Lab217Oficial/Badge_AHAU-CTF_26/Hardware/BOM_AHAU_CTF_Badge_2026.csv

No. | Quantity | Comment | Designator | Footprint | Value | Manufacturer Part | Manufacturer | Supplier Part | Supplier | Pin Count | Category | Description | Datasheet | Width | Mounting Style
1 | 14 | 1uF | C1,C2,C3,C4,C5,C6,C7,C8,C9,C10,C11,C12,C13,C21 | C0603 | 1uF | CL10A105KB8NNNC | SAMSUNG(三星) | C15849 | LCSC | 2 | 電容:0603 | Capacitance:1uF Tolerance:±10% Tolerance:±10% Voltage Rated:50V Temperature Coefficient:X5R | https://atta.szlcsc.com/upload/public/pdf/source/20160103/1457707679084.pdf |  | SMT
2 | 1 | 1000uF | C14 | CAP-SMD_BD12.5-L12.8-W12.8-LS13.5-FD | 1000uF | EDH108M025A9RAA | KEMET(基美) | C2166241 | LCSC | 2 | Capacitors:Aluminum Electrolytic Capacitors - SMD | Capacitance:1000uF Tolerance:±20% Tolerance:±20% Voltage Rating:25V Ripple Current:510mA@120Hz Diameter:12.5mm Lifetime:2000hrs@105℃ Operating Temperature:-40℃~+105℃ Operating Temperature:-40℃~+105℃ Polarity type:有极性 | https://item.szlcsc.com/datasheet/EDH108M025A9RAA/2258293.html |  | SMT
3 | 1 | PH2.0-2PWT | CN1 | CONN-SMD_PH2.0-2PWT |  | PH2.0-2PWT | XUNPU(讯普) | C52037422 | LCSC | 4 | Connectors:Wire To Board Connector | Pins Structure:1x2P Pitch:2mm Mounting Type:Surface Mount, Right Angle Reference Series:PH Number of Pins:2P Number of Rows:1 Number of PINs Per Row:2 Current Rating:2A Contact Material:Brass Contact Plating:Tin Operating Temperature:-40℃~+85℃ Operating T | https://item.szlcsc.com/datasheet/PH2.0-2PWT/54795753.html |  | SMT
4 | 2 | Screw-Hole-M3 | SCREW1,SCREW2 | M3 Hole |  |  |  |  |  | 1 |  |  |  |  | DIP
5 | 1 | MST-12D18G4 SPDT Slide Switch | SW1 | SW-SMD_MST-12D18G4-SPDT-SLIDE-SWITCH |  | MST-12D18G4 SPDT Slide Switch | SHOU HAN(首韩) | C49023767 | LCSC | 3 | Switches:Slide Switches | Circuit:SPDT Actuator Style:Rectangular Columnar Termination Style:SMD(SMT) Tab Length:9.1mm Width:3.5mm Switch Height:7.5mm Mounting Type:Surface Mount, Right Angle Actuator Color:Black Current Rating:100mA Voltage Rating:12V Life:10,000 Cycles Operating | https://item.szlcsc.com/datasheet/MST-12D18G4%2520SPDT%2520Slide%2520Switch/51384142.html | 3.5mm | SMT
6 | 2 | SWITCH TACTILE | SW2,SW3 | SW-SMD_4P-L5.2-W5.2-P3.7-LS6.4-1 |  | SWITCH TACTILE | hanxia(韩下) | C49234130 | LCSC | 4 | Switches:Tactile Switches | Circuit:SPST Actuator Style:Round Button Operating Force:2.5N Mounting Type:Surface Mount,Vertical Length:5.2mm Width:5.2mm Switch Height:1.5mm with Bracket:Without Bracket Contact Current:50mA Voltage Rating:12V Actuator/Cap Color:Yellow With Lamp:No IP | https://item.szlcsc.com/datasheet/HX%25205.2x5.2x1.5H%2520SWITCH%2520TACTILE/51650191.html | 5.2mm | SMT
7 | 14 | WS2812B-B-V6 | U1,U2,U3,U4,U5,U6,U7,U8,U9,U10,U11,U12,U13,U14 | LED-SMD_4P-L5.0-W5.0-TL_WS2812B-B |  | WS2812B-B-V6 | worldsemi | C52941391 | LCSC | 4 | Optoelectronics:RGB LEDs(Built-in IC) |  | https://item.szlcsc.com/datasheet/WS2812B-B-V6/55856754.html |  | SMT
8 | 1 | Header9P_2.54 | U15 | HDR-TH_9P-P2.54-V-M |  |  |  |  |  | 9 |  |  |  |  | DIP
9 | 1 | ESP32S3_SUPERMINI | U16 | ESP32-S3-SUPERMINI |  |  |  |  |  | 20 |  | esp32 s3 supermini with all of the pins |  |  | SMT
