Lab217Oficial/Badge_AHAU-CTF_26/Hardware/3D_Badge_AHAU_CTF_2026.step

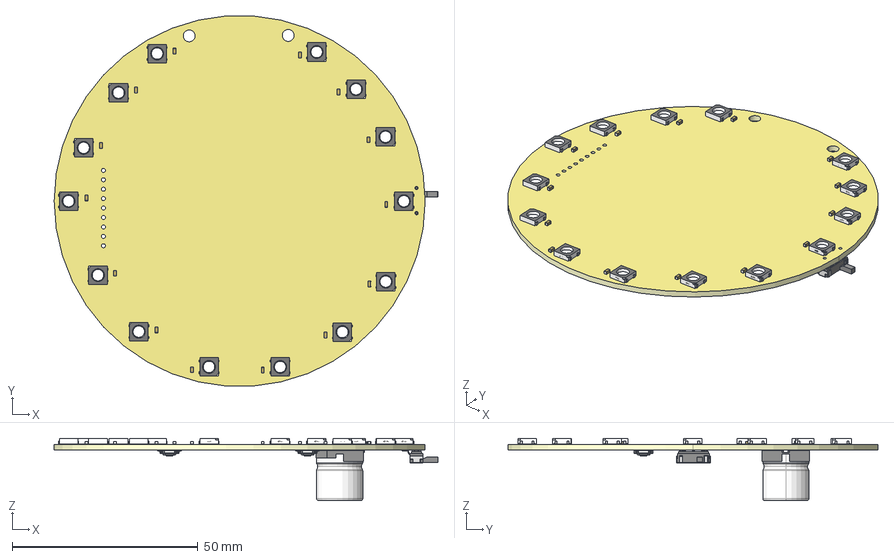
[picture p2: CAD file, 2026-10-14]
Hardware/3D_Badge_AHAU_CTF_2026.step
103.4 x 99.7 x 16.7 mm
Board~4IsV
TopCopper~4IsV
BottomCopper~4IsV
TopSilkscreen~4IsV
BottomSilkscreen~4IsV
TopFpcStiffener~4IsV
BottomFpcStiffener~4IsV
C0603~C0603_L1.6-W0.8-H0.8~4IsV x 14
CAP-SMD_BD12.5-L12.8-W12.8-LS13.5-FD~CAP-SMD_ BD12.5-L12.8-W12.8-LS13.5-FD~4IsV
LED-SMD_4P-L5.0-W5.0-TL_WS2812B-B~LED-SMD_4P-L5.0-W5.0-H1.57-TL_ WS2812B-B~4IsV x 14
SW-SMD_4P-L5.2-W5.2-P3.7-LS6.4-1~SW-SMD_4P-L5.2-W5.2-P3.7-LS6.4-1~4IsV x 2
SW-SMD_MST-12D18G4-SPDT-SLIDE-SWITCH~SW-SMD_ MST-12D18G4-SPDT-SLIDE-SWITCH~4IsV
