Lab217Oficial/Badge_AHAU-CTF_26/Hardware/SCH_Badge_AHAU_CTF_2026.pdf

VOUT_5V | VOUT_5V
VOUT_5V | VOUT_5V

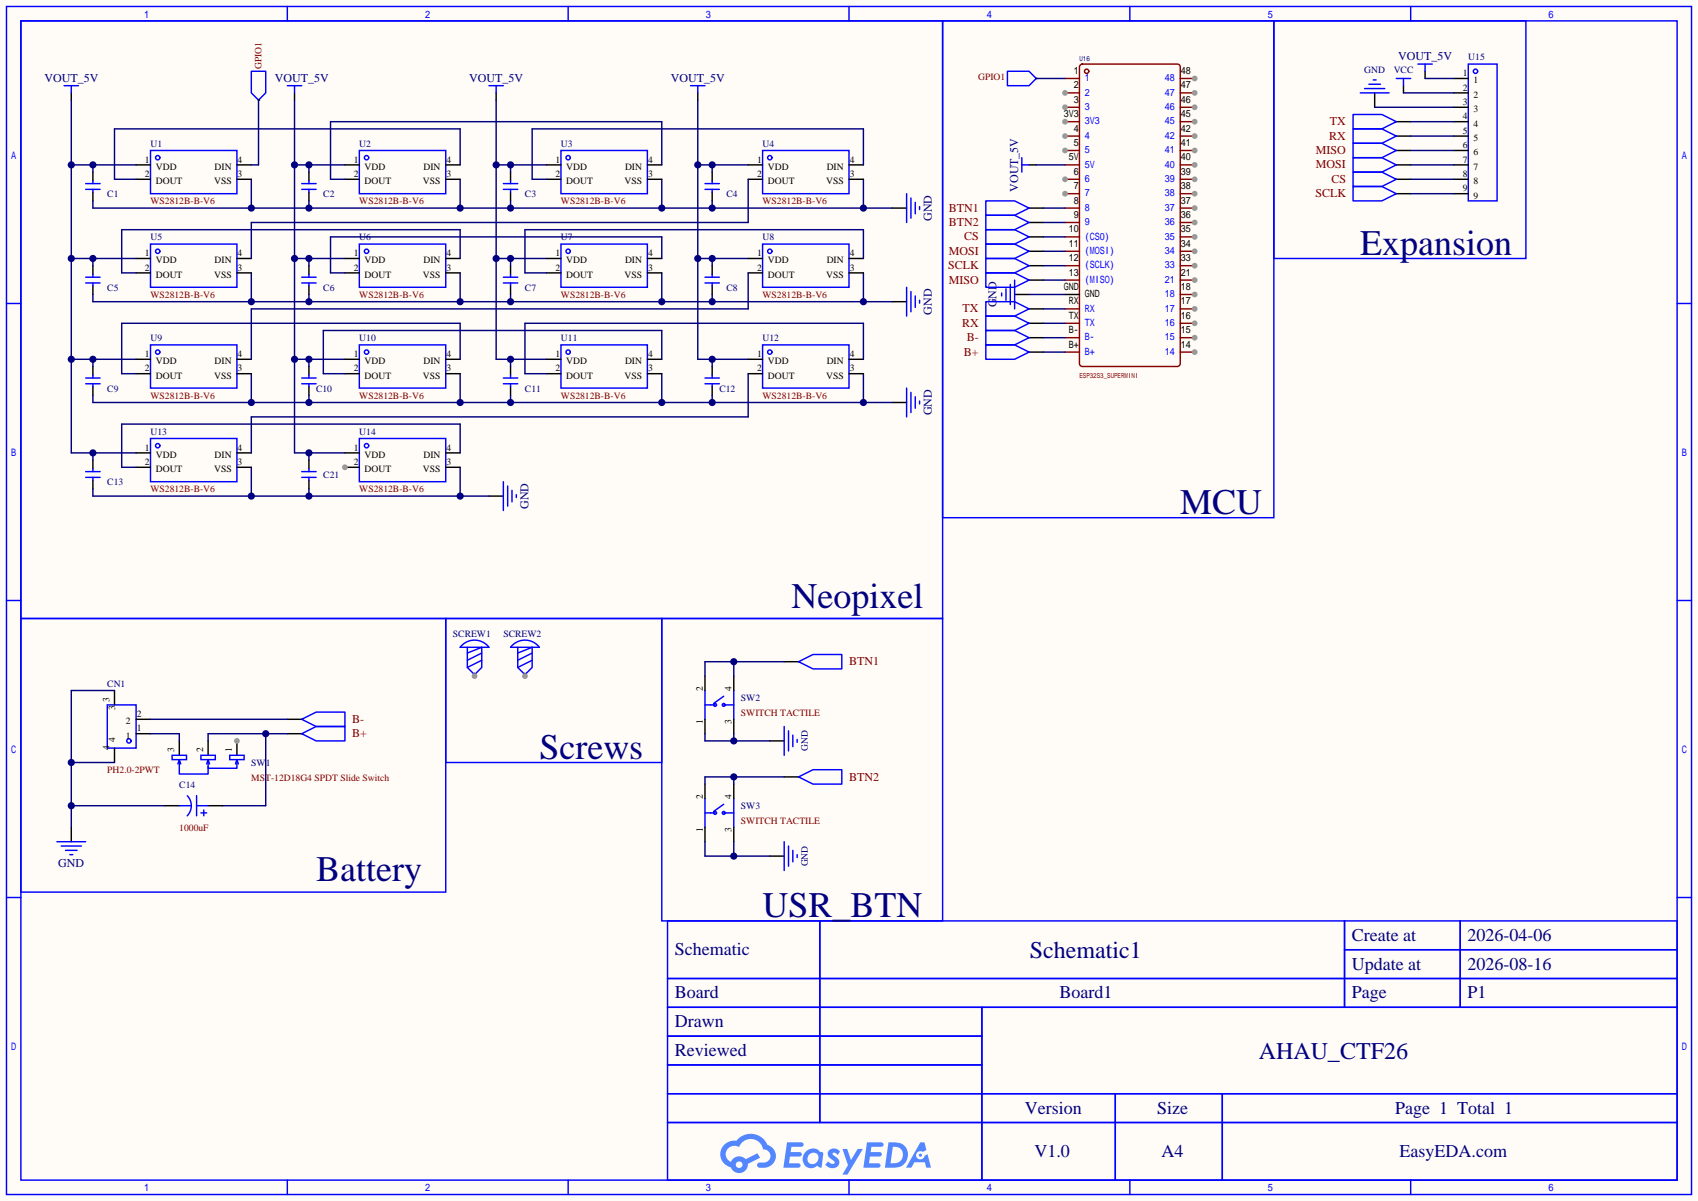
[picture p3: page 1]

Schematic | Schematic1 | Create at | 2026-04-06

Update at | 2026-08-16

Board | Board1 | Page | P1
Drawn | | AHAU_CTF26
Reviewed

Version | Size | Page 1 Total 1

V1.0 | A4 | EasyEDA.com
