Lab217Oficial/Badge_AHAU-CTF_26/(list of files, drawings)

Other design files:
Hardware/AHAU_CTF26_BAdge.epro
