Lab217Oficial/Badge_AHAU-CTF_26/(notices)

Notices in the files:
README.md:
https://img.shields.io/badge/licencia-GPLv3-blue
